dotsolvit/STM32F1-smartUGV-RPi5-Astar/Images/Schematic_STM32F1-smartUGV-RPi5-Astar.png

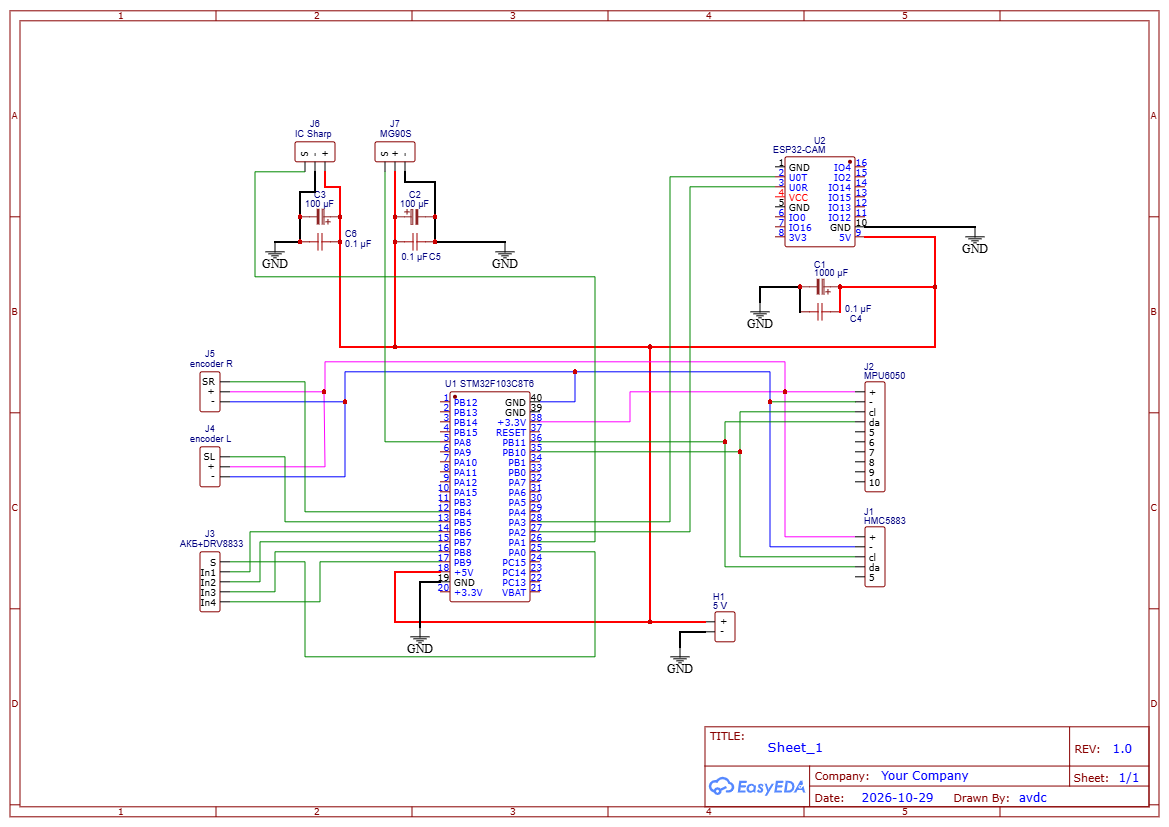
Images/Schematic_STM32F1-smartUGV-RPi5-Astar.png
