dotsolvit/STM32F1-smartUGV-RPi5-Astar/Images/Test UART ESP32-CAM.jpg

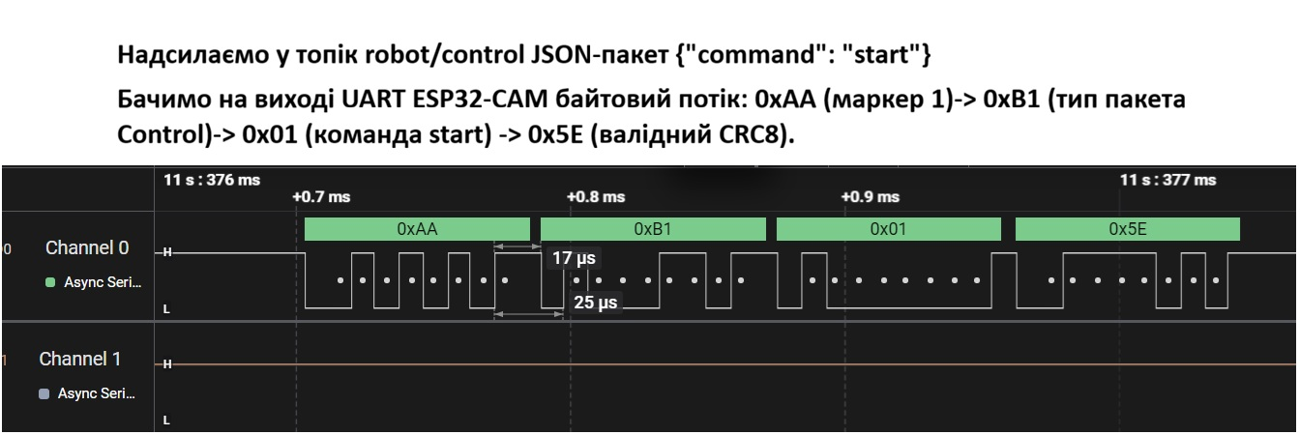
Images/Test UART ESP32-CAM.jpg
