dotsolvit/STM32F1-smartUGV-RPi5-Astar/ESP32-CAM-WIFI-MQTT/ESP32-CAM-WIFI-MQTT.ino

//ESP32-CAM-WIFI-MQTT V2
//Board: AI Thinker ESP32-CAM
//Tools -> Flash Frequency: 80MHz
//Tools -> Partition Scheme: Huge APP (3MB No OTA/1MB SPIFFS)
//Lib: PubSubClient by Nick O'Leary 2.8
//Lib: ArduinoJson by Benoit Blanchon 7.4.3

#include <WiFi.h>
#include <PubSubClient.h>
#include <ArduinoJson.h>
// Підключення секретних налаштувань Wi-Fi
#include "myssid.h" 

#define MAX_SCAN_POINTS 35 // Із розрахунку сканування з кроком 6 градусів від 0 до 180град = 31
#define JSON_BUF_SIZE   1024 // 512 байт для 31 точки може бути впритул, 1024 — ідеально

const int flashPin = 4; // Пін led спалаху на ESP32-CAM
// Налаштування параметрів ШІМ для led спалаху
const int freq = 10000;       // Частота 10 кГц
const int resolution = 8;    // 8-бітна роздільна здатність (0-255)

// WiFi settings 
const char* ssid = MY_WIFI_SSID;
const char* password = MY_WIFI_PASS;
// Налаштування MQTT
const char* mqtt_server = "192.168.1.4"; // IP ADDRESS RPI5
const int mqtt_port = 1883;

WiFiClient espClient;
PubSubClient client(espClient);

// --- СТРУКТУРИ ДЛЯ UART ОБМІНУ З STM32 ---
// Використовуємо #pragma pack(push, 1), щоб структури в пам'яті були без пустих байт-вирівнювань
#pragma pack(push, 1)

// Пакет 1: Команди керування (robot/control -> STM32)
struct ControlPacket {
    uint8_t header1 = 0xAA;
    uint8_t header2 = 0xB1; // Маркер типу пакета (Control)
    uint8_t action;         // 1 - start, 2 - stop, 3 - calibrate
    uint8_t crc8;
};

// Пакет 2: Точка маршруту (robot/path -> STM32). Передаємо по одній точці за раз
struct PathPointPacket {
    uint8_t header1 = 0xAA;
    uint8_t header2 = 0xB2; // Маркер типу пакета (Path Point)
    float x;                // Фізична координата X (метри)
    float y;                // Фізична координата Y (метри)
    uint8_t is_last;        // 1 якщо це остання точка масиву, 0 якщо ні
    uint8_t crc8;
};

// Пакет 3: Телеметрія від STM32 (НОВА СТРУКТУРА: CRC перенесено наперед)
struct UartTelemetryPacket {
    uint8_t header1;       // 0xDE
    uint8_t header2;       // 0x01
    uint8_t crc8;          // Контрольна сума всього, що йде далі
    float x;
    float y;
    float theta_deg;
    uint8_t battery_pct;
    uint8_t status_code;   // 0-stopped, 1-moving, 2-scanning, 3-calibrating, 4-arrived
};

// Пакет 4: Сканування перешкод від STM32 (НОВА СТРУКТУРА: CRC перенесено наперед)
struct UartScanPacket {
    uint8_t header1;       // 0xDE
    uint8_t header2;       // 0x02
    uint8_t crc8;          // Контрольна сума всього, що йде далі
    int16_t angle;         // Поточний кут голови (-90...90)
    uint16_t distance_mm;  // Відстань в мм
    uint8_t is_end_of_scan;// 1 якщо це останній вимір панорами
};
#pragma pack(pop)

// --- ФУНКЦІЯ ОБЧИСЛЕННЯ CRC8 (Dallas/Maxim) ---
uint8_t getCRC8(uint8_t *buffer, uint8_t size) {
    uint8_t crc = 0x00;
    for (uint8_t i = 0; i < size; i++) {
        uint8_t data = buffer[i];
        for (uint8_t j = 8; j > 0; j--) {
            uint8_t mix = (crc ^ data) & 0x01;
            crc >>= 1;
            if (mix) crc ^= 0x8C;
            data >>= 1;
        }
    }
    return crc;
}

// --- ОБРОБКА ДАНИХ З СЕРВЕРА RPi5 (MQTT -> ESP32 -> UART STM32) ---
void mqttCallback(char* topic, byte* payload, unsigned int length) {
    String strTopic = String(topic);
    
    // 1. Обробка команд robot/control
    if (strTopic == "robot/control") {
        StaticJsonDocument<128> doc;
        if (deserializeJson(doc, payload, length) == DeserializationError::Ok) {
            String cmd = doc["command"] | "stop";
            ControlPacket p;
            if (cmd == "start") p.action = 1;
            else if (cmd == "stop") p.action = 2;
            else if (cmd == "calibrate") p.action = 3;
            else p.action = 2; // Безпека: за замовчуванням стоп
            
            p.crc8 = getCRC8((uint8_t*)&p.action, 1);
            Serial.write((uint8_t*)&p, sizeof(p)); // Відправляємо на STM32
        }
    }
    
    // 2. Обробка маршруту robot/path
    else if (strTopic == "robot/path") {
        // Динамічний документ, бо масив точок може бути великим
        DynamicJsonDocument doc(2048);
        if (deserializeJson(doc, payload, length) == DeserializationError::Ok) {
            JsonArray points = doc["points"];
            size_t total_points = points.size();
            
            for (size_t i = 0; i < total_points; i++) {
                PathPointPacket p;
                p.x = points[i]["x"] | 0.0f;
                p.y = points[i]["y"] | 0.0f;
                p.is_last = (i == total_points - 1) ? 1 : 0;
                
                // Рахуємо CRC8 для даних пакета (x, y, is_last займають 9 байт)
                p.crc8 = getCRC8((uint8_t*)&p.x, 9);
                
                Serial.write((uint8_t*)&p, sizeof(p));
                delay(5); // Невелика затримка, щоб STM32 встигав приймати потік точок
            }
        }
    }
}

// --- ПРИЙОМ ДАНИХ ВІД STM32 (UART -> ESP32 -> MQTT RPi5) ---
enum RxState { WAIT_H1, WAIT_H2, READ_DATA };

void handleUartRx() {
    static RxState state = WAIT_H1;
    static uint8_t rx_buf[64];
    static uint8_t rx_idx = 0;
    static uint8_t expected_len = 0;
    
    // Статичні масиви для збору повної панорами
    static int16_t scan_angles[MAX_SCAN_POINTS];
    static int32_t scan_distances[MAX_SCAN_POINTS];
    static uint8_t scan_count = 0;
    
    while (Serial.available() > 0) {
        uint8_t b = Serial.read();
        
        switch (state) {
            case WAIT_H1:
                if (b == 0xDE) {
                    rx_buf[0] = b;
                    rx_idx = 1;
                    state = WAIT_H2;
                }
                break;
                
            case WAIT_H2:
                rx_buf[rx_idx++] = b;
                if (b == 0x01) {       // Зловили телеметрію
                    expected_len = sizeof(UartTelemetryPacket); // Авто-розмір
                    state = READ_DATA;
                } else if (b == 0x02) { // Зловили точку сканування
                    expected_len = sizeof(UartScanPacket);      // Авто-розмір
                    state = READ_DATA;
                } else {
                    state = WAIT_H1;   // Невідомий підтип пакету, скидаємо
                }
                break;
                
            case READ_DATA:
                rx_buf[rx_idx++] = b;
                
                // Чекаємо накопичення повної структури в буфері
                if (rx_idx >= expected_len) {
                    uint8_t type = rx_buf[1]; // Дивимось на тип пакету
                    
                    // --- ОБРОБКА ПАКЕТУ ТЕЛЕМЕТРІЇ (0x01) ---
                    if (type == 0x01) {
                        UartTelemetryPacket* p = (UartTelemetryPacket*)rx_buf;
                        uint16_t data_size = sizeof(UartTelemetryPacket) - 3;
                        
                        // Автоматичний підрахунок CRC8 від поля x до кінця структури
                        if (getCRC8((uint8_t*)&p->x, data_size) == p->crc8) {
                            
                            const char* status_strings[] = {"stopped", "moving", "scanning", "calibrating", "arrived"};
                            const char* current_status = (p->status_code < 5) ? status_strings[p->status_code] : "stopped";
                            
                            // Синтаксис ArduinoJson v7 (Універсальний JsonDocument)
                            JsonDocument jsonDoc;
                            jsonDoc["x"] = p->x;
                            jsonDoc["y"] = p->y;
                            jsonDoc["theta_deg"] = p->theta_deg;
                            jsonDoc["battery_pct"] = p->battery_pct;
                            jsonDoc["status"] = current_status;
                            
                            char out_buf[256];
                            serializeJson(jsonDoc, out_buf);
                            client.publish("robot/telemetry", out_buf);
                        }
                    }
                    
                    // --- ОБРОБКА ПАКЕТУ С КАНУВАННЯ (0x02) ---
                    else if (type == 0x02) {
                        UartScanPacket* p = (UartScanPacket*)rx_buf;
                        uint16_t data_size = sizeof(UartScanPacket) - 3;
                        
                        // Автоматичний підрахунок CRC8 від поля angle до кінця структури
                        if (getCRC8((uint8_t*)&p->angle, data_size) == p->crc8) {
                            
                            if (scan_count < MAX_SCAN_POINTS) {
                                scan_angles[scan_count] = p->angle;
                                scan_distances[scan_count] = p->distance_mm;
                                scan_count++;
                            }
                            
                            // Якщо це фінальна точка або переповнення буфера буферизації
                            if (p->is_end_of_scan == 1 || scan_count >= MAX_SCAN_POINTS) {
                                
                                // Синтаксис ArduinoJson v7 для створення масивів
                                JsonDocument scanDoc;
                                JsonArray angles_arr = scanDoc["angles"].to<JsonArray>();
                                JsonArray dist_arr = scanDoc["distances"].to<JsonArray>();
                                
                                for (uint8_t i = 0; i < scan_count; i++) {
                                    angles_arr.add(scan_angles[i]);
                                    dist_arr.add(scan_distances[i]);
                                }
                                
                                char out_buf[JSON_BUF_SIZE];
                                serializeJson(scanDoc, out_buf, sizeof(out_buf));
                                client.publish("robot/obstacle_scan", out_buf);
                                
                                scan_count = 0; // Скидаємо накопичувач панорами
                            }
                        }
                    }
                    
                    // Після обробки (або якщо CRC не збігся) повертаємось в очікування
                    state = WAIT_H1;
                }
                break;
        }
        
        // Захист від критичного виходу за межі буфера
        if (rx_idx >= 64) {
            rx_idx = 0;
            state = WAIT_H1;
        }
    }
}


void setup() {
    // UART0 ініціалізація (Швидкість зв'язку з STM32)
    Serial.begin(115200);

    // Налаштування ШІМ для led спалаху: пін, частота та бітність.
    ledcAttach(flashPin, freq, resolution);
    // Стан для блимання (true - горить, false - вимкнено)
    bool ledState = false;

    // Wi-Fi Менеджер підключення з індикацією підключення
    WiFi.begin(ssid, password);
    while (WiFi.status() != WL_CONNECTED) {
        // Змінюємо стан на протилежний при кожній ітерації
        ledState = !ledState;
        // Якщо true — вмикаємо легке поблискування (яскравість 3), якщо false — вимикаємо
        ledcWrite(flashPin, ledState ? 3 : 0);
        delay(500);
    }
    // Результат успішного підключення: постійно горить на мінімумі (яскравість 1)
    ledcWrite(flashPin, 1);
    
    client.setServer(mqtt_server, mqtt_port);
    client.setCallback(mqttCallback);
}

void reconnectMQTT() {
    static uint32_t last_reconnect = 0;
    if (!client.connected() && (millis() - last_reconnect > 5000)) {
        last_reconnect = millis();
        if (client.connect("SmartUGV_ESP32_Bridge")) {
            client.subscribe("robot/control");
            client.subscribe("robot/path");
        }
    }
}

void loop() {
    if (!client.connected()) {
        reconnectMQTT();
    }
    client.loop();
    handleUartRx();
}
