dotsolvit/STM32F1-smartUGV-RPi5-Astar/STM32F103-smartUGV/Core/Src/main.c

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
/* Includes ------------------------------------------------------------------*/
#include "main.h"
#include "adc.h"
#include "i2c.h"
#include "tim.h"
#include "usart.h"
#include "gpio.h"

/* USER CODE BEGIN Includes */
#include "telemetry_module.h"
/* USER CODE END Includes */


/* USER CODE BEGIN PV */
// Виділяємо пам'ять під стан робота. Початковий стан — СТОП.
volatile RobotState_t current_robot_state = ROBOT_STATE_STOPPED;

// Виділяємо пам'ять під маршрут робота.
volatile PathPoint_t robot_path[MAX_PATH_POINTS];
volatile uint8_t robot_path_size = 0;
volatile uint8_t robot_new_path_ready = 0;

//Організація асинхронного таймера відправки (50 мс)
uint32_t last_telemetry_tick = 0;
const uint32_t TELEMETRY_INTERVAL_MS = 50;

// Глобальні змінні стану робота (для демонстрації інтеграції)
float robot_x = 4.0f;
float robot_y = 4.0f;
float robot_theta_deg = 90.0f;
uint8_t robot_battery_pct = 80;
/* USER CODE END PV */

void SystemClock_Config(void);
/* USER CODE BEGIN PFP */

// Асинхронна відправка телеметрії (викликається по таймеру кожні 50 мс)
void STM32_SendTelemetry(float x, float y, float theta, uint8_t battery, RobotState_t state) {
    UartTelemetryPacket_t pkt;
    pkt.header1 = 0xDE;
    pkt.header2 = 0x01;
    pkt.x = x;
    pkt.y = y;
    pkt.theta_deg = theta;
    pkt.battery_pct = battery;
    pkt.status_code = (uint8_t)state;

    // Рахуємо від першого корисного поля (x) до самого кінця структури
    uint16_t data_size = sizeof(UartTelemetryPacket_t) - 3;
    pkt.crc8 = STM32_GetCRC8((uint8_t*)&pkt.x, data_size);

    // Побайтова швидка відправка в регістр USART2
    uint8_t *pData = (uint8_t*)&pkt;
    for (uint8_t i = 0; i < sizeof(UartTelemetryPacket_t); i++) {
        while ((USART2->SR & USART_SR_TXE) == 0);
        USART2->DR = pData[i];
    }
}

// Асинхронна відправка однієї точки сканування перешкод
void STM32_SendScanPoint(int16_t angle, uint16_t distance_mm, uint8_t is_last) {
    UartScanPacket_t pkt;
    pkt.header1 = 0xDE;
    pkt.header2 = 0x02;
    pkt.angle = angle;
    pkt.distance_mm = distance_mm;
    pkt.is_end_of_scan = is_last;

    // Рахуємо від першого корисного поля (angle) до самого кінця структури
    uint16_t data_size = sizeof(UartScanPacket_t) - 3;
    pkt.crc8 = STM32_GetCRC8((uint8_t*)&pkt.angle, data_size);

    uint8_t *pData = (uint8_t*)&pkt;
    for (uint8_t i = 0; i < sizeof(UartScanPacket_t); i++) {
        while ((USART2->SR & USART_SR_TXE) == 0);
        USART2->DR = pData[i];
    }
}

/* USER CODE END PFP */

/**
  * @brief  The application entry point.
  * @retval int
  */
int main(void)
{

  /* MCU Configuration--------------------------------------------------------*/

  /* Reset of all peripherals, Initializes the Flash interface and the Systick. */
  HAL_Init();

  /* Configure the system clock */
  SystemClock_Config();

  /* Initialize all configured peripherals */
  MX_GPIO_Init();
  MX_TIM1_Init();
  MX_TIM4_Init();
  MX_ADC1_Init();
  MX_I2C2_Init();
  MX_TIM2_Init();
  MX_TIM3_Init();
  MX_USART2_UART_Init();
  /* USER CODE BEGIN 2 */
  __HAL_UART_ENABLE_IT(&huart2, UART_IT_RXNE); // Вмикаємо переривання по прийому байта
  Telemetry_Init(); // Ініціалізуємо таймери, одометрію та сенсори
  /* USER CODE END 2 */

  /* Infinite loop */
  /* USER CODE BEGIN WHILE */
  while (1)
  {

		// 1. Постійно оновлюємо математику телеметрії (всередині неблокуючі автомати)
		Telemetry_Update();

		// 2. Асинхронний таймер відправки результатів на RPi5 через ESP32 кожні 50 мс
		uint32_t current_tick = HAL_GetTick();
		if (current_tick - last_telemetry_tick >= TELEMETRY_INTERVAL_MS)
		{
			last_telemetry_tick = current_tick;

			// Відправляємо чисті, синхронізовані дані з модуля телеметрії
			STM32_SendTelemetry(robot_x, robot_y, robot_theta_deg, robot_battery_pct, current_robot_state);
		}

		// Тут буде логіка Модуля Пілота...

      /* USER CODE END WHILE */
      /* USER CODE BEGIN 3 */
  }
  /* USER CODE END 3 */
}

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
