dotsolvit/STM32F1-smartUGV-RPi5-Astar/STM32F103-smartUGV/Core/Inc/main.h

#define MAX_PATH_POINTS 50 // Максимальна кількість точок у маршруті із запасом
