dotsolvit/STM32F1-smartUGV-RPi5-Astar/(commit log)

2026-11-04 Added asynchronous packet reception on STM32 (USART2)
2026-11-04 Added comment to stm32f1xx_it.c
2026-11-05 Added Test UART ESP32-CAM.jpg
