dotsolvit/STM32F1-smartUGV-RPi5-Astar/(notices)

Notices in the files:
STM32F103-smartUGV/Core/Src/main.c:
Copyright (c) 2026 STMicroelectronics.
All rights reserved.
This software is licensed under terms that can be found in the LICENSE file
